EvansMike/PiUPS/README.md

# PiUPS
An UPS hat for Raspberry Pi
See doc/UPS.adoc
