EvansMike/PiUPS/schematic2/schematic2.kicad_pcb

## KiCad design schematic2/schematic2.kicad_pcb (2022-03-21)

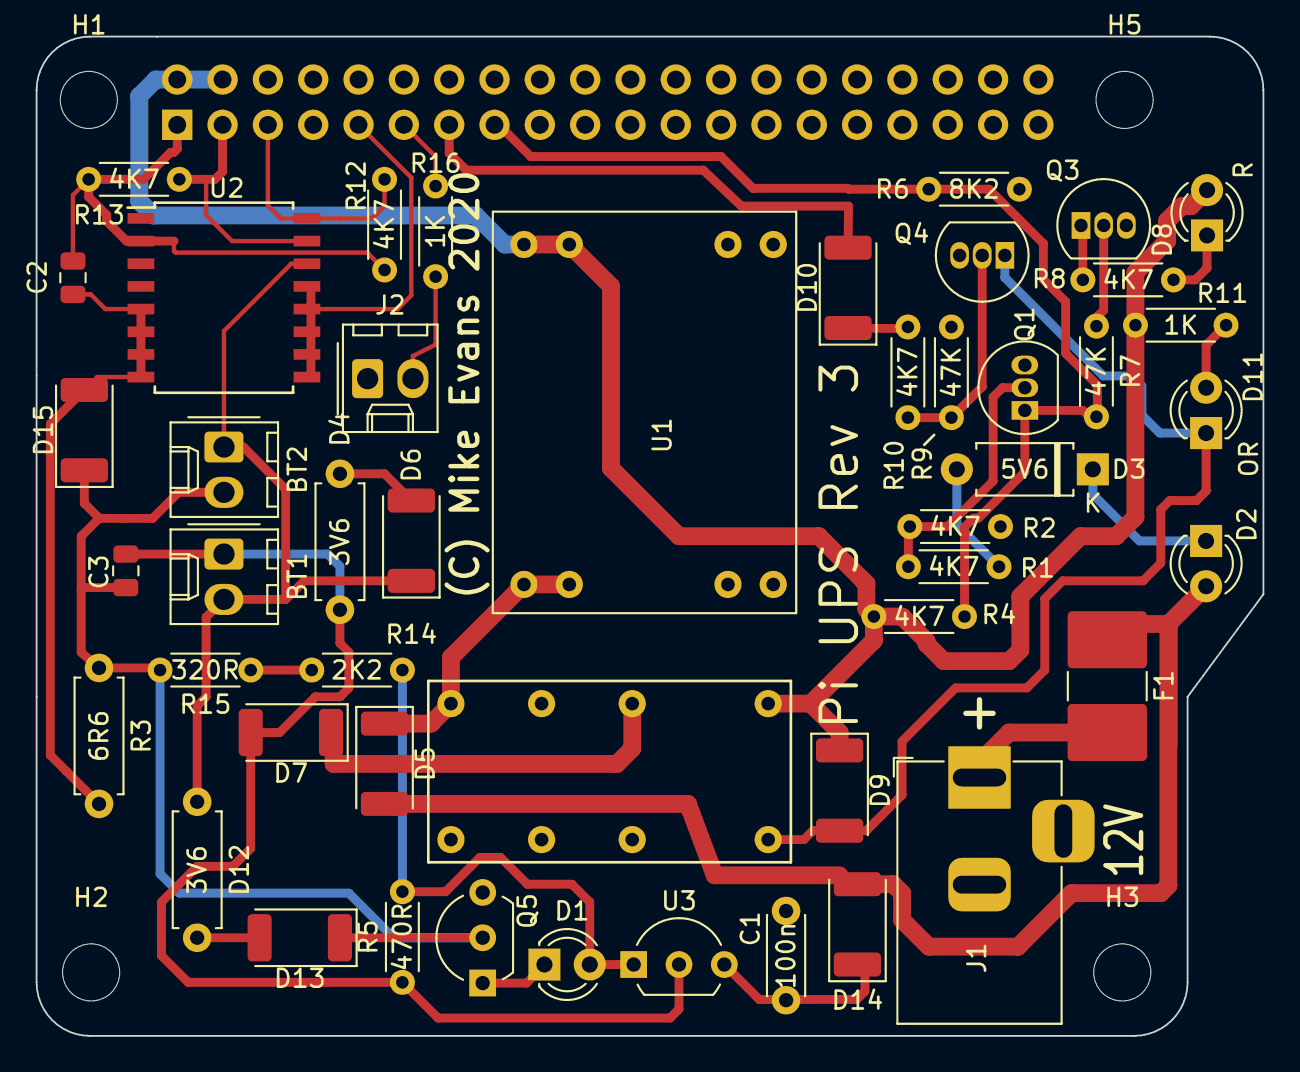
[picture p3: board schematic2.kicad_pcb from above]

Board: 2 copper layers, 68.8 x 56.0 mm, 52 parts (1 on the bottom side), 32 nets.

Parts:
BT1, BT2: Battery_Cell; Molex_KK-254_AE-6410-02A_1x02_P2.54mm_Vertical
C1: 100n; C_Disc_D4.3mm_W1.9mm_P5.00mm
C2: 100nF; C_0805_2012Metric
C3: 100n; C_0805_2012Metric
D1: LED; LED_D3.0mm
D2: G; LED_D3.0mm
D3: 5V6; D_A-405_P7.62mm_Horizontal
D4, D12: 3V6; R_Axial_DIN0207_L6.3mm_D2.5mm_P7.62mm_Horizontal
D5, D6, D7, D9, D13, D14, D15: 1N4001; D_2010_5025Metric
D8: R; LED_D3.0mm
D10: 1N4148; D_2010_5025Metric
D11: OR; LED_D3.0mm
F1: Polyfuse; Fuse_2816_7142Metric_Pad3.20x4.45mm_HandSolder
H1, H2, H3, H5: MountingHole; MountingHole_3.2mm_M3
J1: Barrel_Jack; BarrelJack_Horizontal
J2: Conn_01x02; Molex_KK-254_AE-6410-02A_1x02_P2.54mm_Vertical
K1: TIANBO_HJR_1-2C; Relay_DPDT_HJR_1-2C
P1: Conn_02x20_Odd_Even; PinSocket_2x20_P2.54mm_Vertical
Q1, Q3, Q4: BC547; TO-92_Inline
Q5: BC547; TO-92L_Inline_Wide
R1, R2, R4, R8, R10, R12, R13: 4K7; R_Axial_DIN0204_L3.6mm_D1.6mm_P5.08mm_Horizontal
R3: 6R6; R_Axial_DIN0207_L6.3mm_D2.5mm_P7.62mm_Horizontal
R5: 470R; R_Axial_DIN0204_L3.6mm_D1.6mm_P5.08mm_Horizontal
R6: 8K2; R_Axial_DIN0204_L3.6mm_D1.6mm_P5.08mm_Horizontal
R7, R9: 47K; R_Axial_DIN0204_L3.6mm_D1.6mm_P5.08mm_Horizontal
R11, R16: 1K; R_Axial_DIN0204_L3.6mm_D1.6mm_P5.08mm_Horizontal
R14: 2K2; R_Axial_DIN0204_L3.6mm_D1.6mm_P5.08mm_Horizontal
R15: 320R; R_Axial_DIN0204_L3.6mm_D1.6mm_P5.08mm_Horizontal
U1: buck; BUCK_MODULE_5V
U2: DS3231M; SOIC-16W_7.5x10.3mm_P1.27mm
U3: LM317_SOT-223; TO-92L_Inline_Wide

Connections:
+3V3: C2.1, P1.1, R12.2, R13.2, U2.2
+5V: D8.2, D9.1, K1.16, P1.2, P1.4, R4.2, R11.2, U1.4
+9V: D2.2, D5.2, D14.2, F1.1
BUTTON: P1.11, R16.1
CLK_BAT: BT1.2, BT2.1, D6.1, D12.1, U2.14
GND: C1.2, C2.2, D15.2, J1.2, J2.1, P1.6, P1.9, P1.14, P1.20, P1.25, P1.30, P1.34, P1.39, Q1.3, Q3.3, Q4.3, Q5.3, R2.2, R3.2, R6.1, R9.1, U1.2, U1.3, U2.5, U2.6, U2.7, U2.8, U2.9, U2.10, U2.11, U2.12, U2.13
unnamed: BT1.1, C3.1, D4.1, D7.2, R5.1, U3.2
unnamed: BT2.2, C3.2, D13.1, D15.1, Q5.2, R3.1, R15.2
unnamed: C1.1, D14.1, U3.3
unnamed: D1.1, Q5.1
unnamed: D1.2, R5.2, R14.1, U3.1
unnamed: D2.1, D3.1
unnamed: D3.2, R1.1
unnamed: D4.2, D6.2
unnamed: D5.1, K1.9, U1.1
unnamed: D7.1, K1.13
unnamed: D8.1, R8.2
unnamed: D10.1, R10.1
unnamed: D9.2, D11.1, K1.1, Q4.1
unnamed: D11.2, R11.1
unnamed: D12.2, D13.2
unnamed: F1.2, J1.1
unnamed: J2.2, R16.2
unnamed: Q1.2, R1.2, R2.1
unnamed: Q3.1, R8.1
unnamed: Q3.2, R7.1
unnamed: Q4.2, R9.2, R10.2
unnamed: R14.2, R15.1
PI_P_SIG: D10.2, P1.13
POWER_FAIL: P1.15, Q1.1, R4.1, R6.2, R7.2
SCL1: P1.5, R12.1, U2.16
SDA1: P1.3, R13.1, U2.15
