EvansMike/PiUPS/(commit log)

2018-07-06 new file: schematic2.kicad_pcb new file: schematic2.lib new file: schematic2.sch
    [schematic2.kicad_pcb, schematic2.sch]
2018-07-10 modified: schematic2/schematic2.kicad_pcb new file: schematic2/schematic2.pro modified: schematic2/schematic2.sch
    [schematic2.kicad_pcb, schematic2.sch]
2018-07-12 add fuse and logo.
    [schematic2.kicad_pcb, schematic2.sch]
2018-07-12 Add cache. new file: schematic2-cache.lib
2018-07-12 Change clock for discreets.
    [schematic2.kicad_pcb, schematic2.sch]
2018-07-12 Convert blocks to sheets.
    At this point only the schematic is changed.
    [schematic2.sch]
2018-07-12 Layout done.
    [schematic2.kicad_pcb, schematic2.sch]
2018-07-13 Put the prebuilt buck converter back.
    It's cheaper and easier.
    [schematic2.kicad_pcb, schematic2.sch]
2018-07-24 Final V1 Ordered.
    [schematic2.kicad_pcb]
2018-07-26 Added EEPROM
    [schematic2.kicad_pcb, schematic2.sch]
2018-07-26 Fix wrongly connected clock battery reg
    [schematic2.kicad_pcb, schematic2.sch]
2018-08-09 Runs on the Pi to call shutddown if the power outage is long enough, new file: powermon.py
2018-08-09 Fix it so it works.
    [powermon.py]
2018-08-09 Fix wron wiring to clock.
    [schematic2.kicad_pcb, schematic2.sch]
2018-08-09 Bug#196
    Working. Could be better. Perhaps 2 callbacks, rising & falling.
    [powermon.py]
2018-08-09 Added sub sheet and some annotations. new file: powermon.service
    [schematic2.sch]
2018-08-09 Added content to empty file. modified: powermon.service
2018-08-15 Power the 3V line instead of the 5V.
    [schematic2.kicad_pcb, schematic2.sch]
2019-01-24 modified: doc/UPS.adoc modified: firmware/src/powermon.py modified: schematic2/schematic2-cache.lib modified: schematic2/schematic2.kicad_pcb modified: schematic2/schematic2.sch
    [schematic2.kicad_pcb, schematic2.sch]
2021-08-05 Mostly layout changes.
    [clock.sch, schematic2.kicad_pcb, schematic2.sch]
2021-08-05 Sch. Moved stuff for aesthetics.
    [schematic2.sch]
2021-08-11 modified: schematic2.kicad_pcb
    [schematic2.kicad_pcb]
2021-08-11 Remove un-needed FET.
    [schematic2.kicad_pcb, schematic2.sch]
2022-03-18 Boards ordered.
    [clock.sch, schematic2.kicad_pcb, schematic2.sch]
2022-03-21 Revert back to KiCAD5
    Because the benchy pi cannont run V6.
    [schematic2.kicad_pcb]
2022-03-21 Update powermon.py a bit.
    Also move stuff.
